UncorkedStudios/Simone/(commit log)

2018-02-15 Uploaded arduino sketches and build instructions
2018-02-15 added GPL text to arduino sketches
2018-02-19 added enclosure designs
